peteEH/usbHub-2host-1device/README.md

# usbHub-2host-1device
Single Device can be switched between two hosts

## LICENSE ##
Hardware License is Creative Commons - Attribution 3.0

Feel free to use these files to learn, explore electronics.
