peteEH/usbHub-2host-1device/USB_HubSwitch/USB_HubSwitch.kicad_pcb

## KiCad design USB_HubSwitch/USB_HubSwitch.kicad_pcb (2019-10-26)

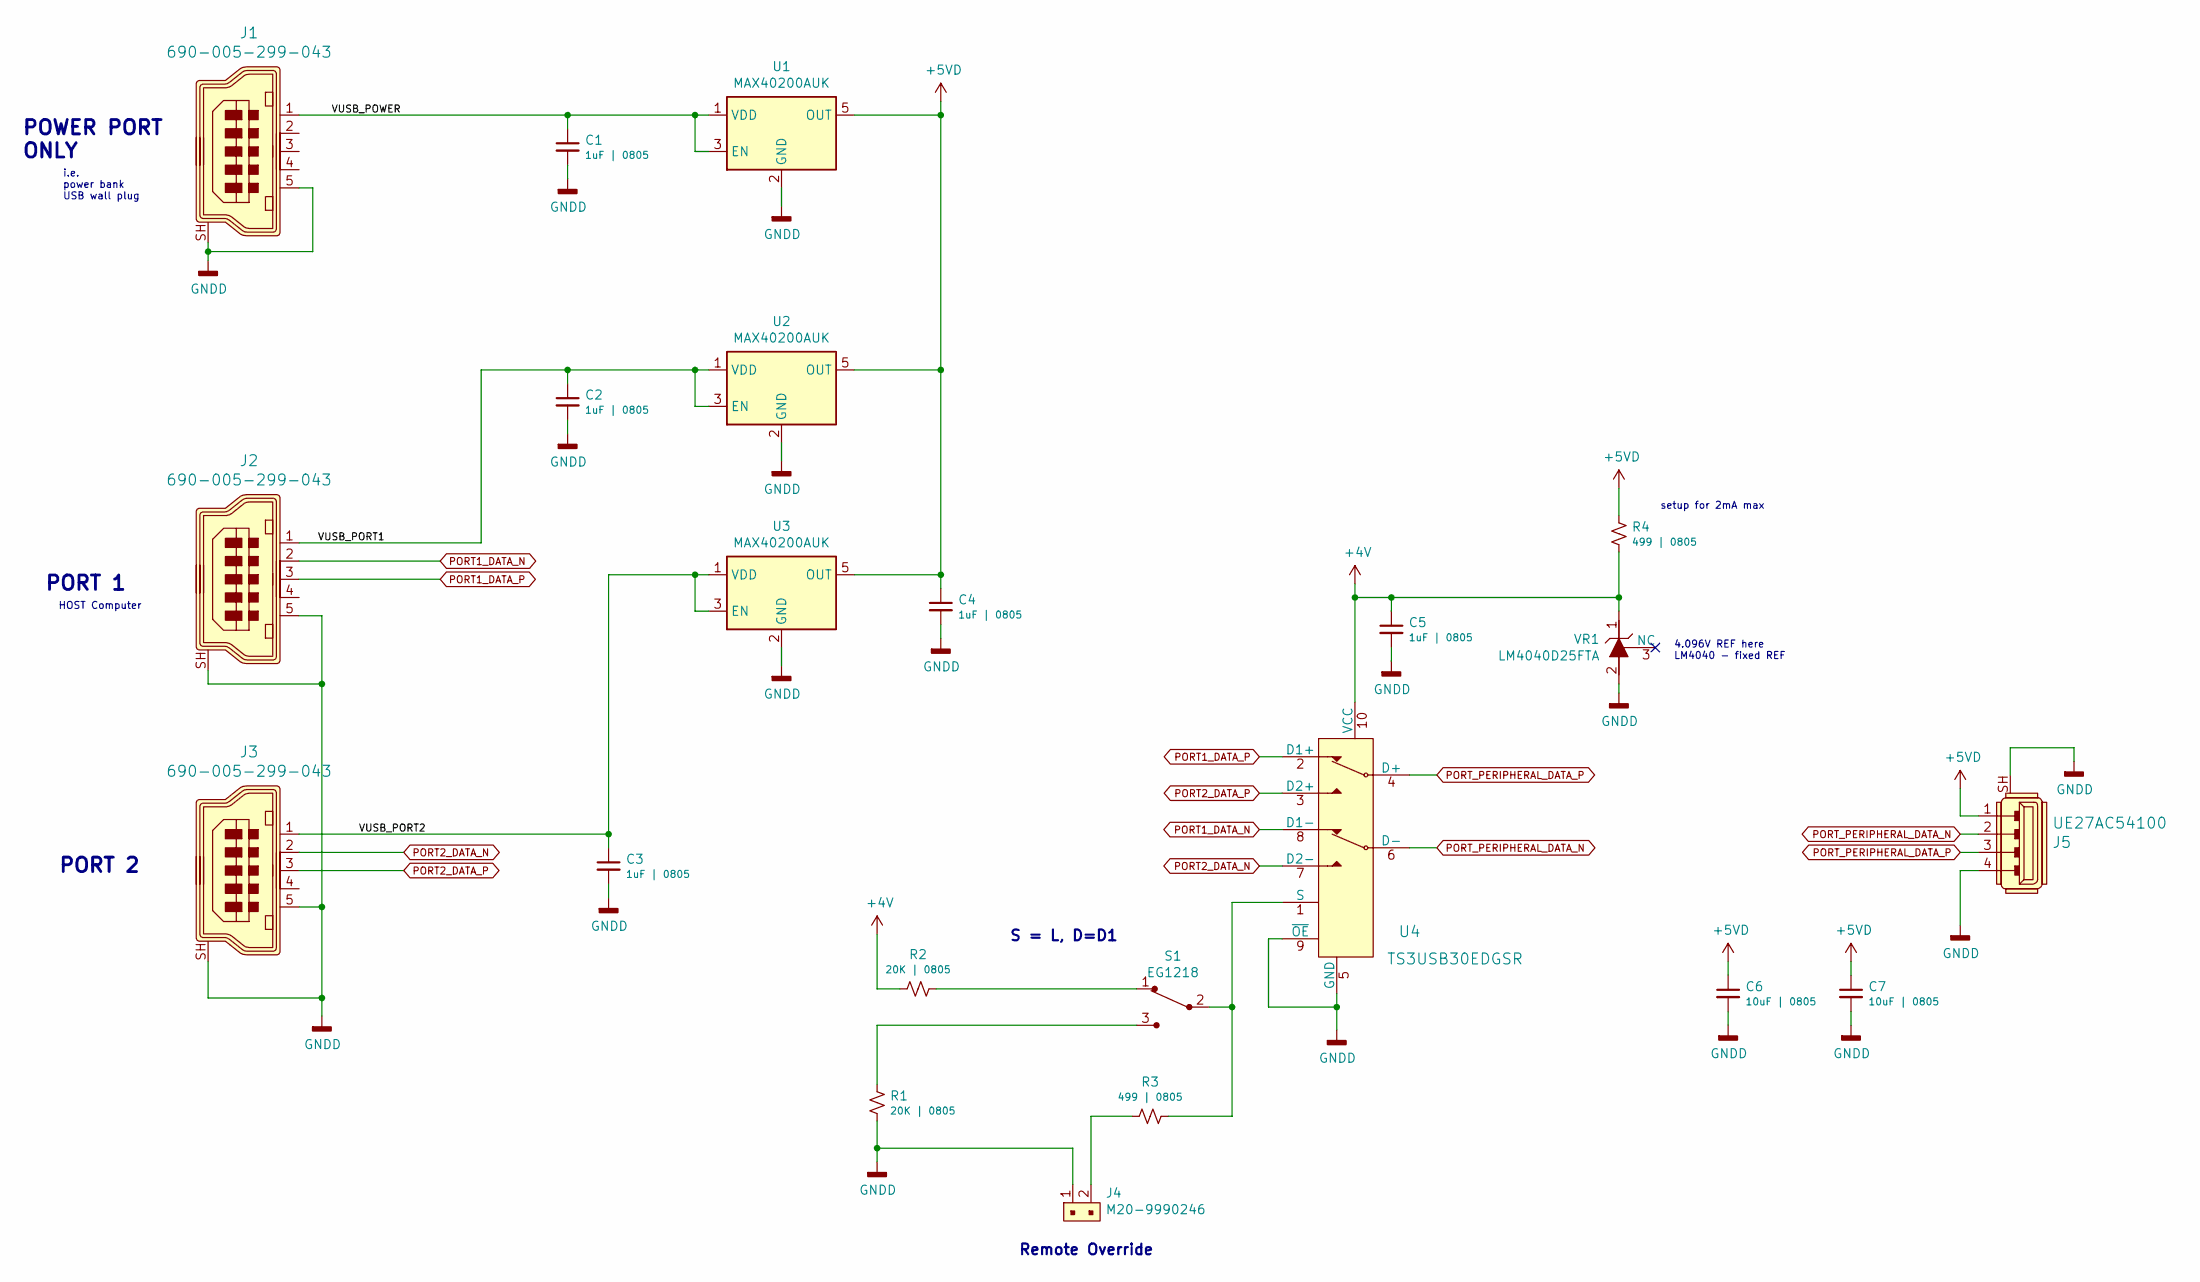
[picture p1: schematic USB_HubSwitch.sch, USB Switch]

Parts:
C1, C2, C3, C4, C5: 1uF | 0805; C_0805_2012Metric
C6, C7: 10uF | 0805; C_0805_2012Metric
J1, J2, J3: 690-005-299-043; USB_Mini_B_Female_690-005-299-043; MPN 690-005-299-043; Digi-Key_PN 151-1206-1-ND
J4: M20-9990246; PinHeader_1x2_P2.54mm; MPN M20-9990246; Digi-Key_PN 952-2262-ND
J5: UE27AC54100; USB_A_Female_UE27AC54100; MPN UE27AC54100; Digi-Key_PN UE27AC54100-ND
R1, R2: 20K | 0805; R_0805_2012Metric
R3, R4: 499 | 0805; R_0805_2012Metric
S1: EG1218; Switch_Slide_11.6x4mm_EG1218; MPN EG1218; Digi-Key_PN EG1903-ND
U1, U2, U3: MAX40200AUK; SOT-23-5
U4: TS3USB30EDGSR; MSOP-10_W3mm; MPN TS3USB30EDGSR; Digi-Key_PN 296-25495-1-ND
VR1: LM4040D25FTA; SOT-23-3; MPN LM4040D25FTA; Digi-Key_PN LM4040D25FCT-ND

Connections:
+4V: C5.1, R2.2, R4.2, U4.10 (VCC), VR1.1
+5VD: C4.1, C6.1, C7.1, J5.1, R4.1, U1.5 (OUT), U2.5 (OUT), U3.5 (OUT)
/VUSB_PORT1: C2.1, J2.1, U2.1 (VDD), U2.3 (EN)
/VUSB_PORT2: C3.1, J3.1, U3.1 (VDD), U3.3 (EN)
/VUSB_POWER: C1.1, J1.1, U1.1 (VDD), U1.3 (EN)
GNDD: C1.2, C2.2, C3.2, C4.2, C5.2, C6.2, C7.2, J1.5, J1.SH, J2.5, J2.SH, J3.5, J3.SH, J4.1, J5.4, J5.SH, R1.2, U1.2 (GND), U2.2 (GND), U3.2 (GND), U4.5 (GND), U4.9 (~OE), VR1.2
unnamed: J4.2, R3.2
unnamed: R1.1, S1.3
unnamed: R2.1, S1.1
unnamed: R3.1, S1.2, U4.1 (S)
PORT1_DATA_N: J2.2, U4.8 (D1-)
PORT1_DATA_P: J2.3, U4.2 (D1+)
PORT2_DATA_N: J3.2, U4.7 (D2-)
PORT2_DATA_P: J3.3, U4.3 (D2+)
PORT_PERIPHERAL_DATA_N: J5.2, U4.6 (D-)
PORT_PERIPHERAL_DATA_P: J5.3, U4.4 (D+)

Notes on the sheet:
4.096V REF here LM4040 - fixed REF
setup for 2mA max
PORT 1
PORT 2
POWER PORT ONLY
i.e. power bank USB wall plug
HOST Computer
Remote Override
S = L, D=D1

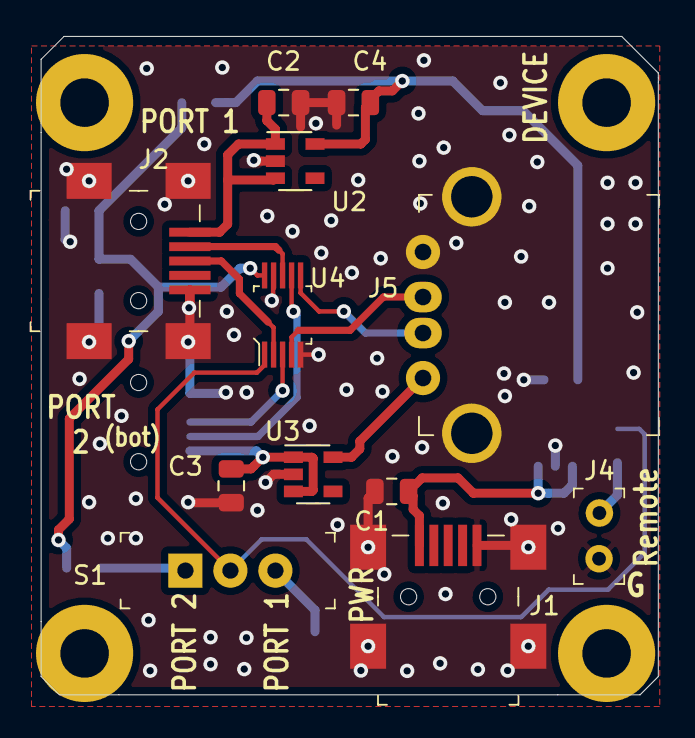
[picture p2: board USB_HubSwitch.kicad_pcb from above]

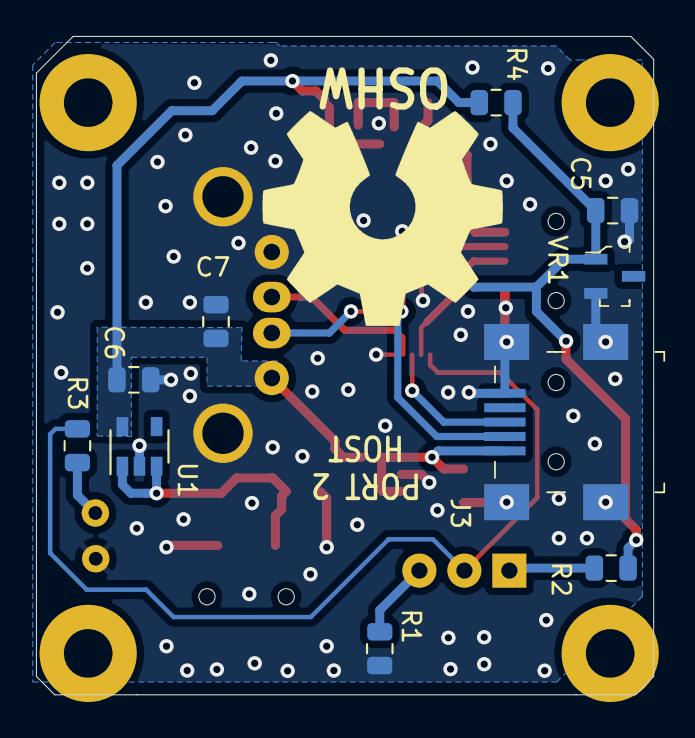
[picture p3: board USB_HubSwitch.kicad_pcb from below]

Board: 2 copper layers, 34.3 x 36.6 mm, 22 parts (10 on the bottom side), 16 nets.
