peteEH/usbHub-2host-1device/(commit log)

2019-10-26 added initial set of design files
    [USB_HubSwitch-B_Cu.gbr, USB_HubSwitch-B_Mask.gbr, USB_HubSwitch-B_SilkS.gbr, USB_HubSwitch-Edge_Cuts.gbr, USB_HubSwitch-F_Cu.gbr, USB_HubSwitch-F_Mask.gbr, USB_HubSwitch-F_SilkS.gbr, USB_HubSwitch-NPTH.drl]
2019-10-26 Fixed USB Receptacle Pinout
    this shall be used... fixed TYPE A pinout, was flipped vertically
    [USB_HubSwitch-B_Cu.gbr, USB_HubSwitch-B_Mask.gbr, USB_HubSwitch-B_SilkS.gbr, USB_HubSwitch-Edge_Cuts.gbr, USB_HubSwitch-F_Cu.gbr, USB_HubSwitch-F_Mask.gbr, USB_HubSwitch-F_SilkS.gbr, USB_HubSwitch-NPTH.drl]
